shadow578/attiny-sleep-mcu/attiny13-sleep-mcu.ino

/**
 * This program is designed to be used with an ATtiny13A microcontroller, using the Arduino IDE and https://github.com/MCUdude/MicroCore.
 * Configure the build as follows:
 * - Board: ATtiny13A
 * - Clock: 1.2 MHz (internal) / maybe slower ? (programming possible ??)
 * - BOD: disable
 * - Bootloader: No
 * - LTO: disable / don't care
 */

#include <avr/io.h>
#include <avr/sleep.h>
#include <util/delay.h>

// pin definitions
constexpr uint8_t PIN_ON = PB0;
constexpr uint8_t PIN_LOAD_EN = PB1;

// for how long the device should sleep before turning on the load again
constexpr uint32_t SLEEP_TIME = 30 * 60; // seconds

// _delay_ms() only works ok for values < 262.14 ms, so we call it multiple times in a loop
constexpr uint32_t SLEEP_TIME_TICK_MS = 100; // how much time to wait in each loop iteration
constexpr uint32_t SLEEP_TIME_TICKS = ((SLEEP_TIME * 1000UL) / SLEEP_TIME_TICK_MS); // number of iterations
static_assert(SLEEP_TIME_TICKS < 0xFFFF, "SLEEP_TIME_TICKS must be less than 0xFFFF");

int main()
{
    // disable ADC, internal COMP, and WDT to reduce power consumption
    ADCSRA &= ~_BV(ADEN); // ADC enable = 0
    ADCSRB &= ~_BV(ACME); // analog comparator multiplexer enable = 0
    ACSR |= _BV(ACD);     // analog comparator disable = 1
    WDTCR &= ~_BV(WDE);   // disable watchdog timer

    // set ON pin to input w/ pull-up
    DDRB &= ~_BV(PIN_ON); // set PIN_ON as input
    PORTB |= _BV(PIN_ON); // enable pull-up on PIN_ON

    // set LOAD_EN to output, set HIGH
    DDRB |= _BV(PIN_LOAD_EN);  // set PIN_LOAD_EN as output
    PORTB |= _BV(PIN_LOAD_EN); // set PIN_LOAD_EN high

    // wait until ON pin is LOW
    while (PINB & _BV(PIN_ON))
        ;

    // set all pins to input, no pull-up, to reduce power consumption
    DDRB = 0x00;  // set all pins to input
    PORTB = 0x00; // disable pull-up on all pins

    // TODO: more power consumption reduction possible ?
    // note: cannot enter any of the sleep mode, since they all disable the CPU.
    
    // reduce clock speed to reduce power consumption
    CLKPR = _BV(CLKPCE);               // enable clock prescaler update
    CLKPR = _BV(CLKPS1) | _BV(CLKPS0); // set clock division factor to 8

    // wait for ~30 minutes
    for (uint32_t i = 0; i < SLEEP_TIME_TICKS; i++)
    {
        _delay_ms(SLEEP_TIME_TICK_MS);
    }

    // reset the MCU using watchdog timer
    WDTCR = _BV(WDE) | _BV(WDP2) | _BV(WDP1); // WDT enable, timeout of ~1s
    while (1)
    {
        // wait for WDT to reset the MCU
    }

    return 0;
}
