shadow578/attiny-sleep-mcu/(commit log)

2024-10-15 change from platformio to arduino for easier fuse config
2024-10-15 Revert "change from platformio to arduino for easier fuse config"
    This reverts commit 18b09a2375621ab72ad09a0bce22918244034e08.
    [main.cpp]
2024-10-15 remove clock speed reduction code reduces cpu clock very low, may cause ISP to fail
    [main.cpp]
2024-10-16 further reduce power consumption + make stuff more readable
2024-10-17 implement wait_for using WDT + minor reset refactoring
    [main.cpp]
2024-10-17 update comments around fuses
2024-10-21 fix cpu reset and wdt sleep function
    [main.cpp]
2024-10-21 add docs about power consuption
2024-10-22 upload schematic.pdf
